partholomew/volcanic-ash-uav/Admin/Gantt.jpg

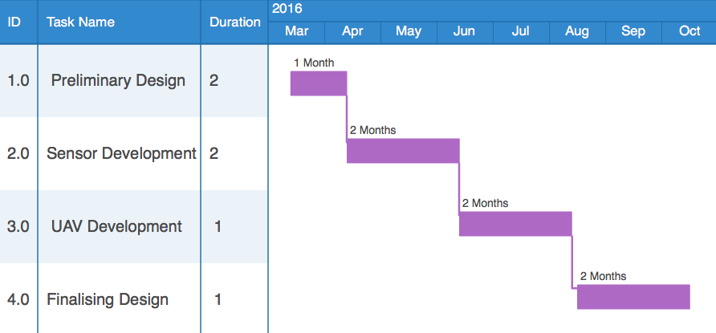
Admin/Gantt.jpg
