partholomew/volcanic-ash-uav/Research/Sensors and Sampling/Sensor Matrix.xlsx

Measurement Needed |  | Sensor | Sensor | Cost | Avalibilty | Development time | Accuracy | Durablity | Form factor
Ash Present |  | Capacitive | Capacitive
 |  | Magnet | Magnet
 |  | Charge | Charge
 |  |  | Camera
Partical Size |  | Camera
 |  | Charge | IR
 |  |  | IR Array
Density |  | IR - Rate
 |  | IR Array - Sum | SO2
 |  | Magnet - Sum | Spectrometer
Chemical composiotion |  | SO2
 |  | Spectrometer
Sample Collector |  | Rotary
 |  | Linear
Plane Sensors | GPS |  | Autopilot |  |  | Air Speed
CPU Matrix
