partholomew/volcanic-ash-uav/CAD Concepts/Concept 2- Bulk Sampling/Concept 2- Bulk Sampling Area.SLDASM

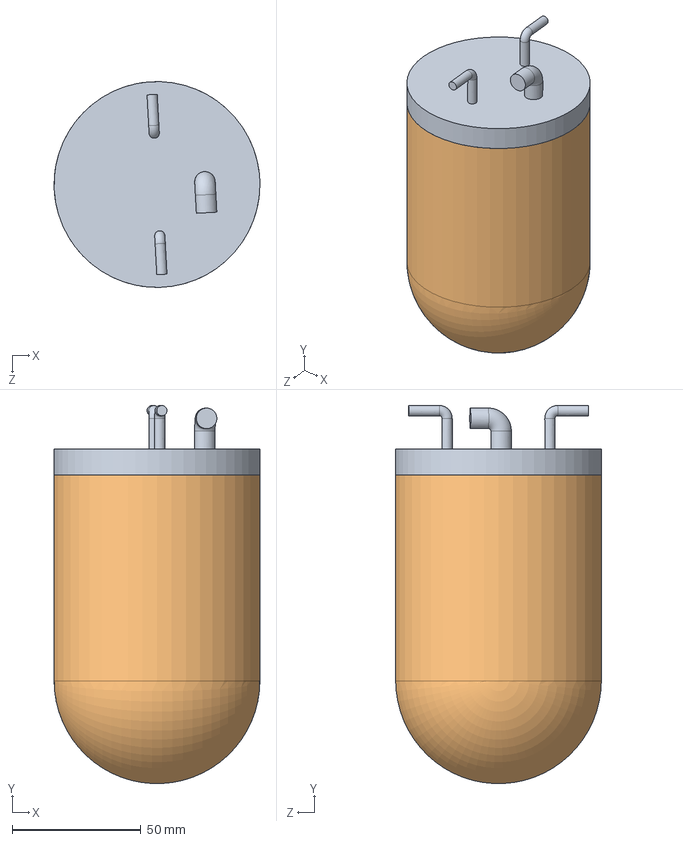
[picture p59: CAD file, 2016-04-01]
CAD Concepts/Concept 2- Bulk Sampling/Concept 2- Bulk Sampling Area.SLDASM
80.0 x 146.9 x 80.0 mm
Top Cap
Container
