partholomew/volcanic-ash-uav/CAD Concepts/Concept 1- Collection/Ash Collection System Concept 1.SLDASM

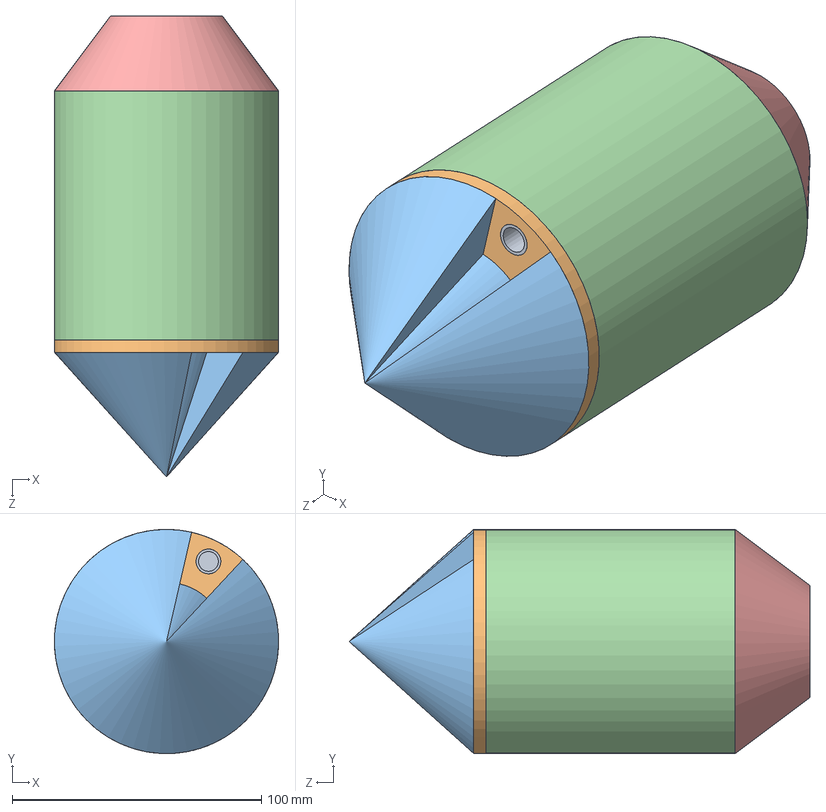
[picture p60: CAD file, 2016-04-01]
CAD Concepts/Concept 1- Collection/Ash Collection System Concept 1.SLDASM
90.0 x 90.0 x 185.0 mm
tube x 6
Wheel
Front Cone
Cover
Back Cone
