partholomew/volcanic-ash-uav/CAD Concepts/Concept 1- Collection/Front.SLDPRT

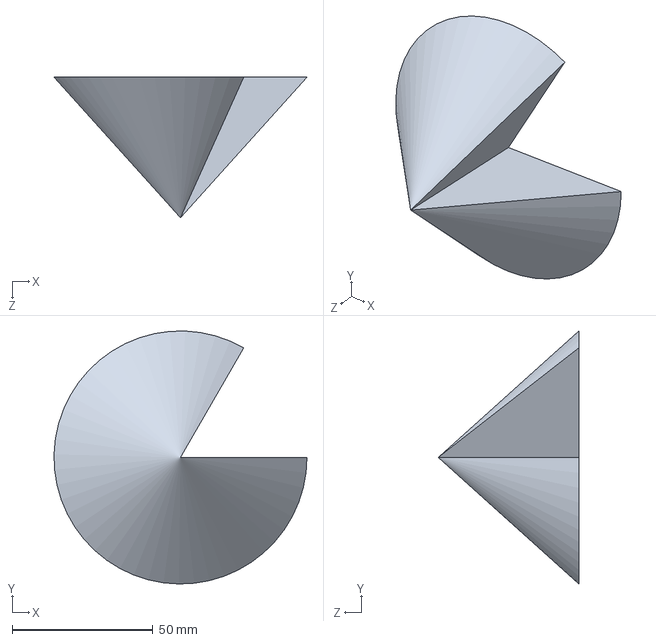
[picture p61: CAD file, 2016-04-01]
CAD Concepts/Concept 1- Collection/Front.SLDPRT
90.0 x 90.0 x 50.0 mm
