partholomew/volcanic-ash-uav/CAD Concepts/Concept 1- Collection/Back Cone.SLDPRT

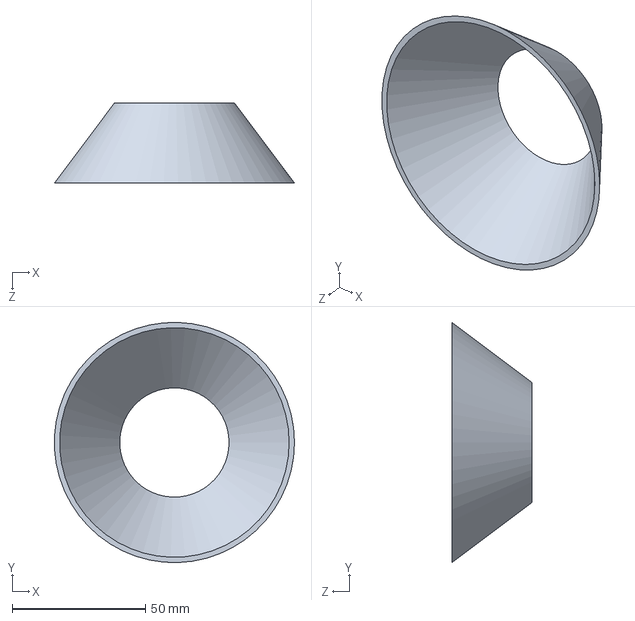
[picture p62: CAD file, 2016-04-01]
CAD Concepts/Concept 1- Collection/Back Cone.SLDPRT
89.9 x 90.0 x 30.0 mm
