partholomew/volcanic-ash-uav/CAD Concepts/Concept 2- Bulk Sampling/Container.SLDPRT

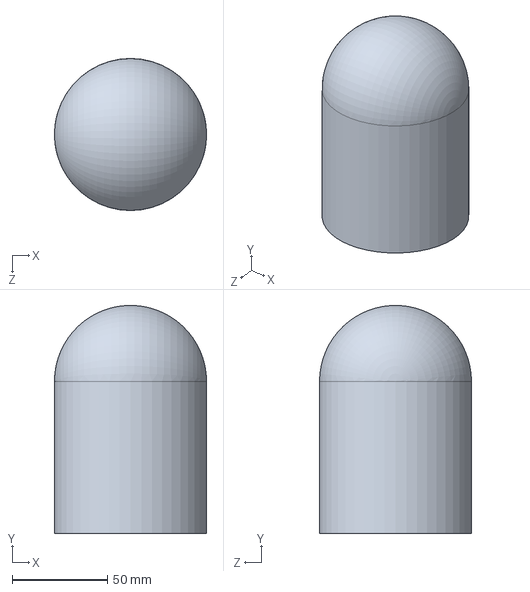
[picture p63: CAD file, 2016-04-01]
CAD Concepts/Concept 2- Bulk Sampling/Container.SLDPRT
80.0 x 119.9 x 80.0 mm
