partholomew/volcanic-ash-uav/CAD Concepts/Concept 1- Collection/tube.SLDPRT

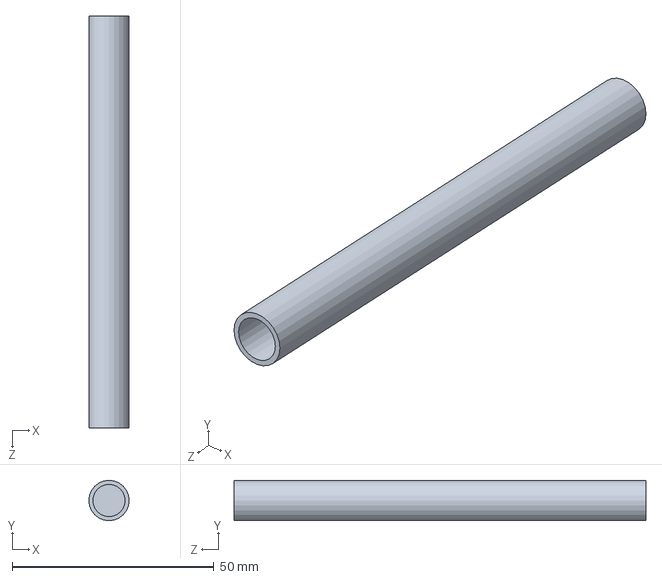
[picture p64: CAD file, 2016-04-01]
CAD Concepts/Concept 1- Collection/tube.SLDPRT
10.0 x 10.0 x 102.0 mm
