partholomew/volcanic-ash-uav/CAD Concepts/Concept 2- Bulk Sampling/Mesh.SLDPRT

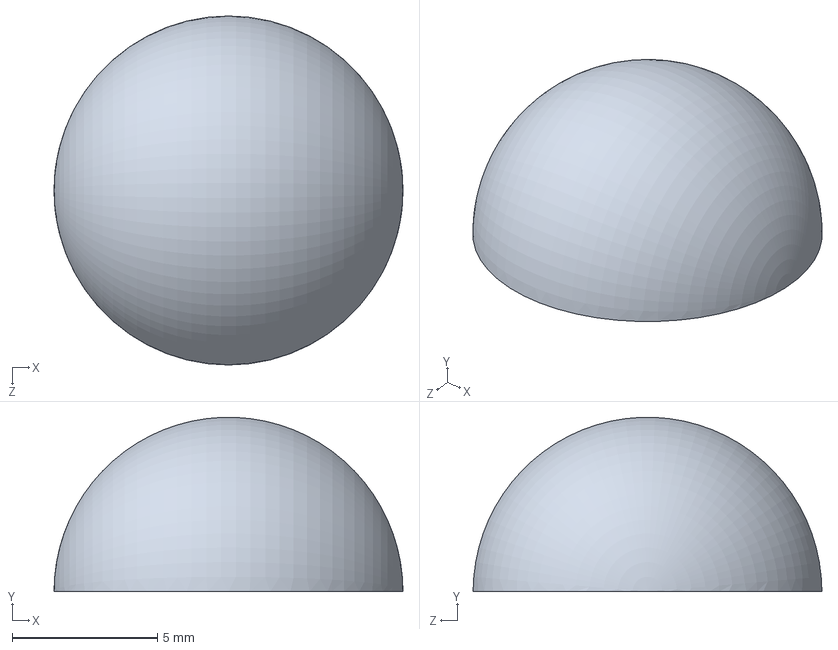
[picture p65: CAD file, 2016-04-01]
CAD Concepts/Concept 2- Bulk Sampling/Mesh.SLDPRT
12.0 x 5.99 x 12.0 mm
