partholomew/volcanic-ash-uav/CAD Concepts/Concept 1- Collection/Wheel.SLDPRT

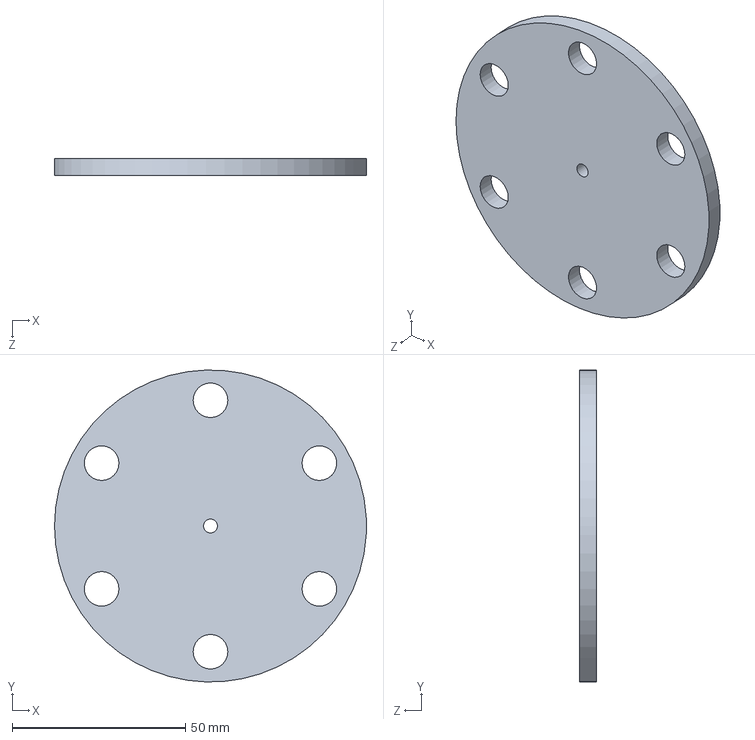
[picture p66: CAD file, 2016-04-01]
CAD Concepts/Concept 1- Collection/Wheel.SLDPRT
90.0 x 90.0 x 5.00 mm
