partholomew/volcanic-ash-uav/CAD Concepts/Concept 2- Bulk Sampling/Top Cap.SLDPRT

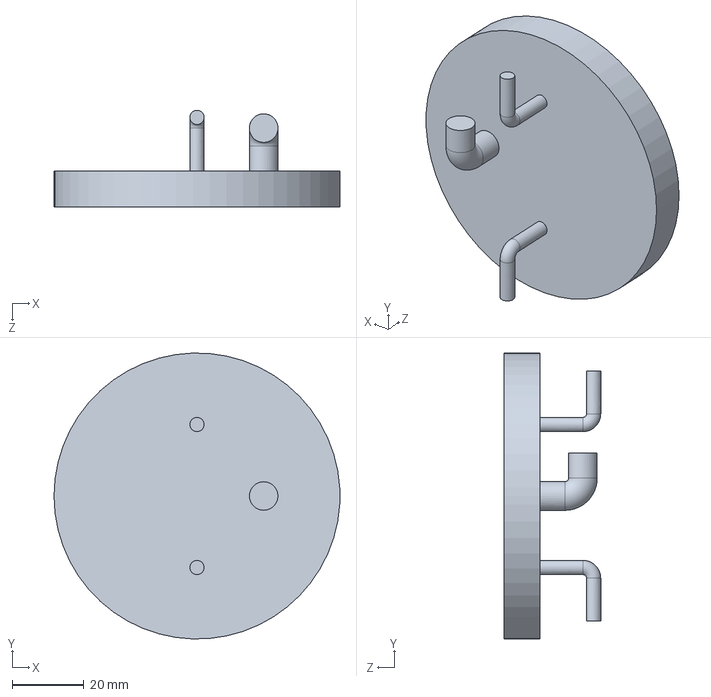
[picture p67: CAD file, 2016-04-01]
CAD Concepts/Concept 2- Bulk Sampling/Top Cap.SLDPRT
80.0 x 80.0 x 27.0 mm
