partholomew/volcanic-ash-uav/CAD Concepts/Concept 1- Collection/Front Cone.SLDPRT

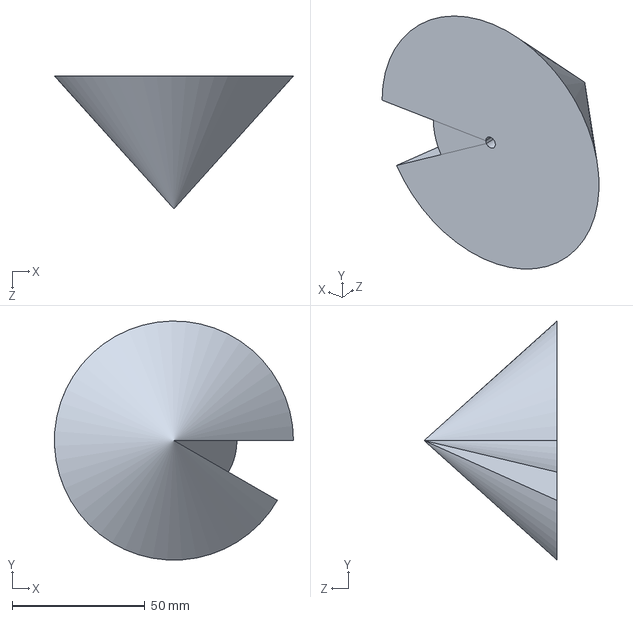
[picture p68: CAD file, 2016-04-01]
CAD Concepts/Concept 1- Collection/Front Cone.SLDPRT
90.0 x 89.9 x 50.0 mm
