partholomew/volcanic-ash-uav/CAD Concepts/Concept 1- Collection/Cover.SLDPRT

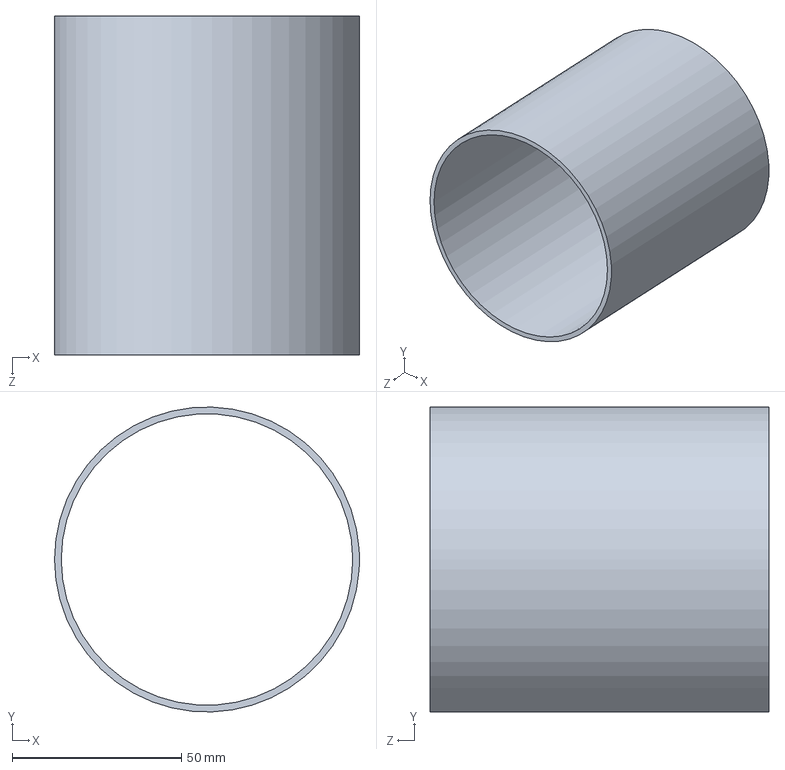
[picture p69: CAD file, 2016-04-01]
CAD Concepts/Concept 1- Collection/Cover.SLDPRT
90.0 x 89.9 x 100.0 mm
