partholomew/volcanic-ash-uav/(list of files, cad)

Other CAD files:
CAD Concepts/Concept 2- Bulk Sampling/Concept 1- Particle sensing.SLDASM
