partholomew/volcanic-ash-uav/(commit log)

2016-03-13 Added research papers/admin docs
    [combinedTimetable.xlsx]
2016-03-15 final version hopefully
    [combinedTimetable.xlsx]
2016-03-22 Adding research for sensors and UAV
    Some useful papers that use cheap ways to measure the VA using infrared
    LEDs and a magnetometer. A couple of UAV designs are also uploaded. Jake
2016-04-01 Cad Folder
    Added a CAD folder and 1st concept for ash collection
    [Ash Collection System Concept 1.SLDASM, Back Cone.SLDPRT, Cover.SLDPRT, Front Cone.SLDPRT, Front.SLDPRT, Wheel.SLDPRT, tube.SLDPRT]
2016-04-01 Concept 2- Bulk Sensing
    This concept collects the samples over a period of time to determine the
    presence of ash particle
    [Concept 1- Particle sensing.SLDASM, Concept 2- Bulk Sampling Area.SLDASM, Container.SLDPRT, Mesh.SLDPRT, Top Cap.SLDPRT]
2016-04-01 CAD concepts
    Added CAD concepts folder with 2 concepts. Concept 1 is for ash
    collection while concept 2 is to measure ash particle concentration.
    [Ash Collection System Concept 1.SLDASM, Back Cone.SLDPRT, Concept 1- Particle sensing.SLDASM, Concept 2- Bulk Sampling Area.SLDASM, Container.SLDPRT, Cover.SLDPRT, Front Cone.SLDPRT, Front.SLDPRT]
2016-04-05 evaluation matrix
    [Sensor Matrix.xlsx]
